RwHexa/LoraRw/BlockdiagramMAX3232.png

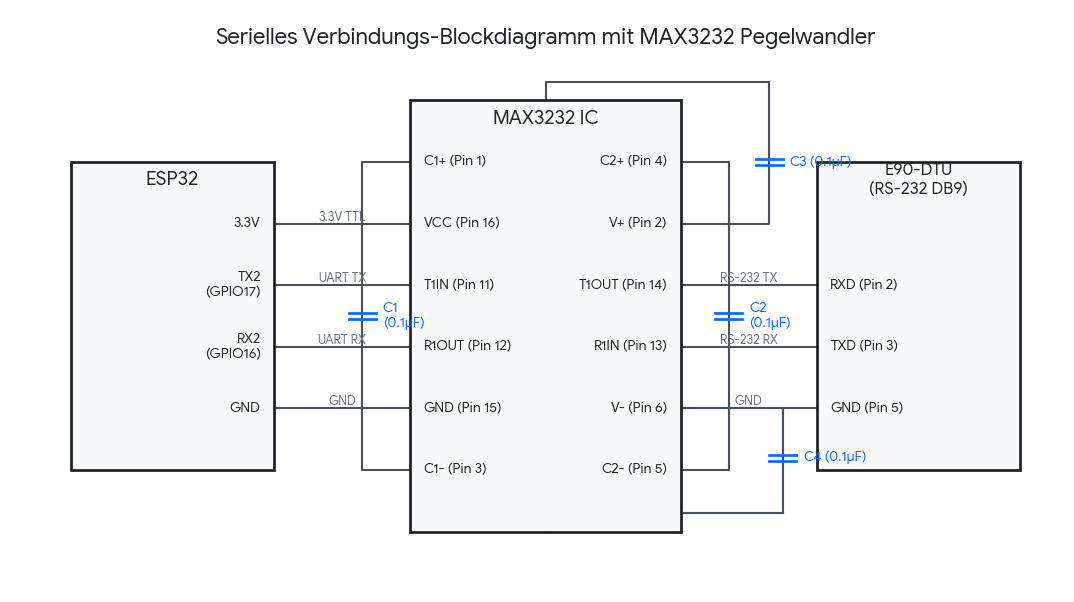
BlockdiagramMAX3232.png
