RwHexa/LoraRw/(commit log)

2026-10-15 Bidirektionale LoRa-Funkstrecke mit E90-DTU und zwei ESP32
    Punkt-zu-Punkt-Strecke auf 868,125 MHz: Controller 1 sendet zwei
    Schaltzustaende und einen Messwert, Controller 2 quittiert und gibt
    einen Schaltbefehl zurueck. Enthalten sind das gemeinsame Protokoll
    (7-Byte-Frame, CRC16, Quittung mit Wiederholung, Failsafe nach 30 s,
    Sendezeit-Budget), beide Sketches, ein Linktest sowie die Doku zu
    Verdrahtung ueber MAX3232-Pegelwandler und zur DTU-Konfiguration.
    [controller1.ino, controller2.ino, linktest.ino, lora_protocol.h]
2026-10-15 README: Foto des E90-DTU einbinden
    Das Modulbild liegt ohnehin im Repo und zeigt auf einen Blick, wo
    RS232, RS485, Versorgung, M0/M1 und Antenne sitzen.
2026-10-15 README: Logo klein neben die Ueberschrift
